shimotoriharuki/2021RoboTrace_Kicad/README.md

# 2021RoboTrace_Kicad

This repository contains circuit data for line-following robot ([UnderBird](https://www.youtube.com/watch?v=3UgktZoH9lk)).

Sourse code is [HERE](https://github.com/shimotoriharuki/2021RoboTracer).

Electronic components list is [HERE](https://lizard-building-630.notion.site/Electronic-components-list-d9b10301a8f747e9818a21101504a1fe).

# License: [GNU General Public License v3.0](https://github.com/shimotoriharuki/2021RoboTrace_Kicad/blob/master/COPYING)
