shimotoriharuki/2021RoboTrace_Kicad/MainBoard/DXF/MainBoard_v1.xlsx

Library | Part | Footprint | Value | Number | Reference
Connector | Micro_SD_Card_Det_Hirose_DM3AT | Connectors_Card:Hirose_DM3AT-SF-PEJM5 | Micro_SD_Card_Det_Hirose_DM3AT | 1 | J5
Connector_Generic | Conn_01x02 | Connectors_JST:JST_SH_BM02B-SRSS-TB_02x1.00mm_Straight | SH | 1 | J6
Connector_Generic | Conn_01x02 | Footprint:ILG_2pin | ILG | 1 | J1
Connector_Generic | Conn_01x02 | Footprint:PA_2pin | PA | 2 | J4, PA1
Connector_Generic | Conn_01x03 | Connectors_JST:JST_SH_BM03B-SRSS-TB_03x1.00mm_Straight | SH | 2 | J13, J11
Connector_Generic | Conn_01x04 | Connectors_JST:JST_SH_BM04B-SRSS-TB_04x1.00mm_Straight | SH | 3 | J2, J10, SH1
Connector_Generic | Conn_01x06 | Connectors_JST:JST_SH_BM06B-SRSS-TB_06x1.00mm_Straight | SH | 2 | J3, J9
Connector_Generic | Conn_01x18 | Footprint:Molex_FFC_18 | FFC | 1 | J12
Connector_Generic | Conn_02x05_Odd_Even | Pin_Headers:Pin_Header_Straight_2x05_Pitch1.27mm | ENC | 2 | J7, J8
Device | Buzzer | Footprint:SMT-0440-S-R | SMT-0440-S-R | 1 | BZ1
Device | CP_Small | Capacitors_SMD:CP_Elec_5x5.8 | 100u | 3 | C2, C27, C43
Device | C_Small | Capacitors_SMD:C_0603 | 0.1u | 15 | C1, C12, C13, C17, C19, C31, C34, C36, C30, C45, C47, C48, C50, C49, C46
Device | C_Small | Capacitors_SMD:C_0603 | 10u | 2 | C33, C44
Device | C_Small | Capacitors_SMD:C_0603 | 1u | 17 | C20, C25, C28, C29, C40, C14, C18, C23, C24, C35, C41, C42, C16, C21, C22, C37, C38
Device | C_Small | Capacitors_SMD:C_0603 | 2.2u | 2 | C39, C15
Device | C_Small | Capacitors_SMD:C_0603 | 3.3n | 1 | C6
Device | C_Small | Capacitors_SMD:C_0603 | 4.7u | 1 | C26
Device | C_Small | Capacitors_SMD:C_0805 | 22u | 4 | C7, C9, C10, C5
Device | C_Small | Capacitors_SMD:C_1210 | 47u | 5 | C3, C32, C4, C8, C11
Device | D_Schottky_Small_ALT | Diodes_SMD:D_SOD-123F | SS2040FL | 2 | D1, D7
Device | D_Zener_Small_ALT | Footprint:1SMB5930BT3G | 1SMB5920BT3G | 1 | D3
Device | D_Zener_Small_ALT | Footprint:1SMB5930BT3G | SZ1SMB5930BT3G | 1 | D2
Device | Ferrite_Bead_Small | Inductors_SMD:L_0603 | 330 | 1 | FB1
Device | Ferrite_Bead_Small | Inductors_SMD:L_0603 | 60 | 6 | FB2, FB3, FB4, FB5, FB6, FB7
Device | L | Footprint:IHLP1212BZER2R2M11 | IHLP1212BZER2R2M11 | 1 | L1
Device | LED_Small_ALT | LEDs:LED_0603 | OSTG1608C1A | 8 | D4, D5, D6, D8, D9, D10, D11, D12
Device | Q_NMOS_GSD | TO_SOT_Packages_SMD:SOT-23 | IRLML6344 | 1 | Q10
Device | R_Pack04 | Resistors_SMD:R_Array_Convex_4x1206 | 4.7k | 1 | RN1
Device | R_Small | Resistors_SMD:R_0603 | 1.2k | 1 | R53
Device | R_Small | Resistors_SMD:R_0603 | 100k | 1 | R2
Device | R_Small | Resistors_SMD:R_0603 | 10k | 14 | R1, R6, R29, R11, R12, R28, R30, R23, R24, R25, R26, R27, R57, R56
Device | R_Small | Resistors_SMD:R_0603 | 2.7k | 2 | R32, R33
Device | R_Small | Resistors_SMD:R_0603 | 22k | 7 | R15, R16, R17, R18, R19, R14, R20
Device | R_Small | Resistors_SMD:R_0603 | 2k | 1 | R4
Device | R_Small | Resistors_SMD:R_0603 | 33k | 2 | R13, R31
Device | R_Small | Resistors_SMD:R_0603 | 390 | 6 | R5, R48, R49, R50, R51, R52
Device | R_Small | Resistors_SMD:R_0603 | 4.7k | 2 | R8, R9
Device | R_Small | Resistors_SMD:R_0603 | 470 | 1 | R55
Device | R_Small | Resistors_SMD:R_0603 | 5k | 1 | R3
Device | R_Small | Resistors_SMD:R_0603 | 680 | 1 | R54
Device | R_Small | Resistors_SMD:R_0603 | R | 18 | R7, R10, R21, R22, R47, R46, R45, R44, R43, R42, R41, R40, R39, R38, R37, R36, R35, R34
Regulator_Switching | TPS62143 | Package_DFN_QFN:VQFN-16-1EP_3x3mm_P0.5mm_EP1.68x1.68mm_ThermalVias | TPS62143 | 1 | U3
Switch | SW_Coded_SH-7050 | Footprint:FR01SC16P | FR01SC16P-S | 1 | SW3
Switch | SW_Push | Footprint:SKRPACE010 | SKRPACE010 | 1 | SW1
Switch | SW_Push_SPDT | Footprint:SSSS213202 | SSSS213202 | 1 | SW2
Transistor_FET | 2N7002K | Package_TO_SOT_SMD:SOT-23 | 2N7002K | 1 | Q7
shimoharu_library | AON7400B | Housings_DFN_QFN:DFN-8-1EP_3x3mm_Pitch0.5mm | AON7400B | 8 | Q1, Q2, Q3, Q4, Q5, Q6, Q8, Q9
shimoharu_library | DRV8701E | Footprint:DRV8701ERGET | DRV8701E | 2 | U6, U10
shimoharu_library | ECS-2520S33 | Crystals:Crystal_SMD_2520-4pin_2.5x2.0mm | ECS-2520S33 | 1 | U4
shimoharu_library | ICM20648 | Footprint:ICM20648 | ICM20648 | 1 | U7
shimoharu_library | INA260 | Housings_SSOP:TSSOP-16_4.4x5mm_Pitch0.65mm | INA260 | 2 | U5, U9
shimoharu_library | LT1963EST-3.3 | TO_SOT_Packages_SMD:SOT-223-3_TabPin2 | LT1963EST-3.3 | 1 | U2
shimoharu_library | MMC5983MA | Footprint:MMC5983MA | MMC5983MA | 1 | U11
shimoharu_library | OSTB0603C1C-A | Footprint:OSTB0603C1C-A | OSTB0603C1C-A | 1 | LED1
shimoharu_library | SI7463DP | Footprint:SO-8_PowerPAK_Vishay_Single | SI7469DP-T1-GE3 | 1 | U1
shimoharu_library | SKRHAAE010 | Footprint:SKRHAAE010 | SKRHAAE010 | 1 | SW4
shimoharu_library | STM32F469VG | Housings_QFP:LQFP-100_14x14mm_Pitch0.5mm | STM32F469VG | 1 | U8
