shimotoriharuki/2021RoboTrace_Kicad/MainBoard/DXF/MainBoard.dxf

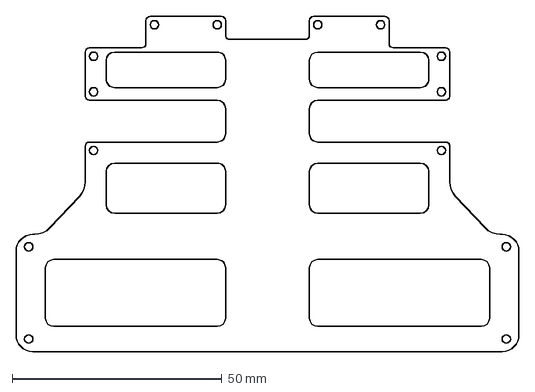
[picture p1: CAD file, 2021-05-12]
MainBoard/DXF/MainBoard.dxf
120.0 x 80.0 mm
