shimotoriharuki/2021RoboTrace_Kicad/MainBoard/MainBoard_v1.step

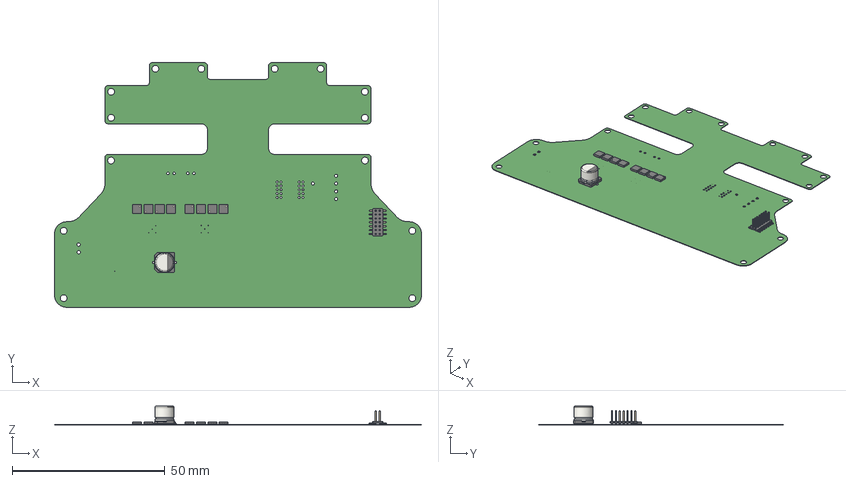
[picture p2: CAD file, 2021-06-06]
MainBoard/MainBoard_v1.step
120.0 x 80.0 x 6.15 mm
