shimotoriharuki/2021RoboTrace_Kicad/FollowingSensor/DXF/edge.dxf

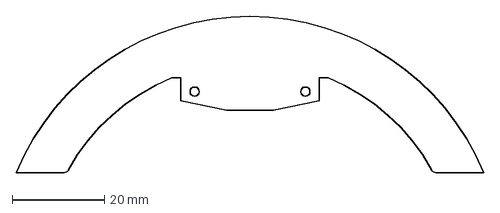
[picture p3: CAD file, 2021-05-12]
FollowingSensor/DXF/edge.dxf
101.6 x 33.9 mm
