shimotoriharuki/2021RoboTrace_Kicad/SideSensor/DXF/edge.dxf

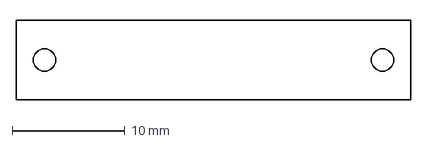
[picture p4: CAD file, 2021-05-12]
SideSensor/DXF/edge.dxf
35.0 x 7.10 mm
