shimotoriharuki/2021RoboTrace_Kicad/(list of files, cad)

Other CAD files:
MainBoard/circuitMainBoard_v1.ipt
