shimotoriharuki/2021RoboTrace_Kicad/FollowingSensor/PDF/FollowingSensor1.0.pdf

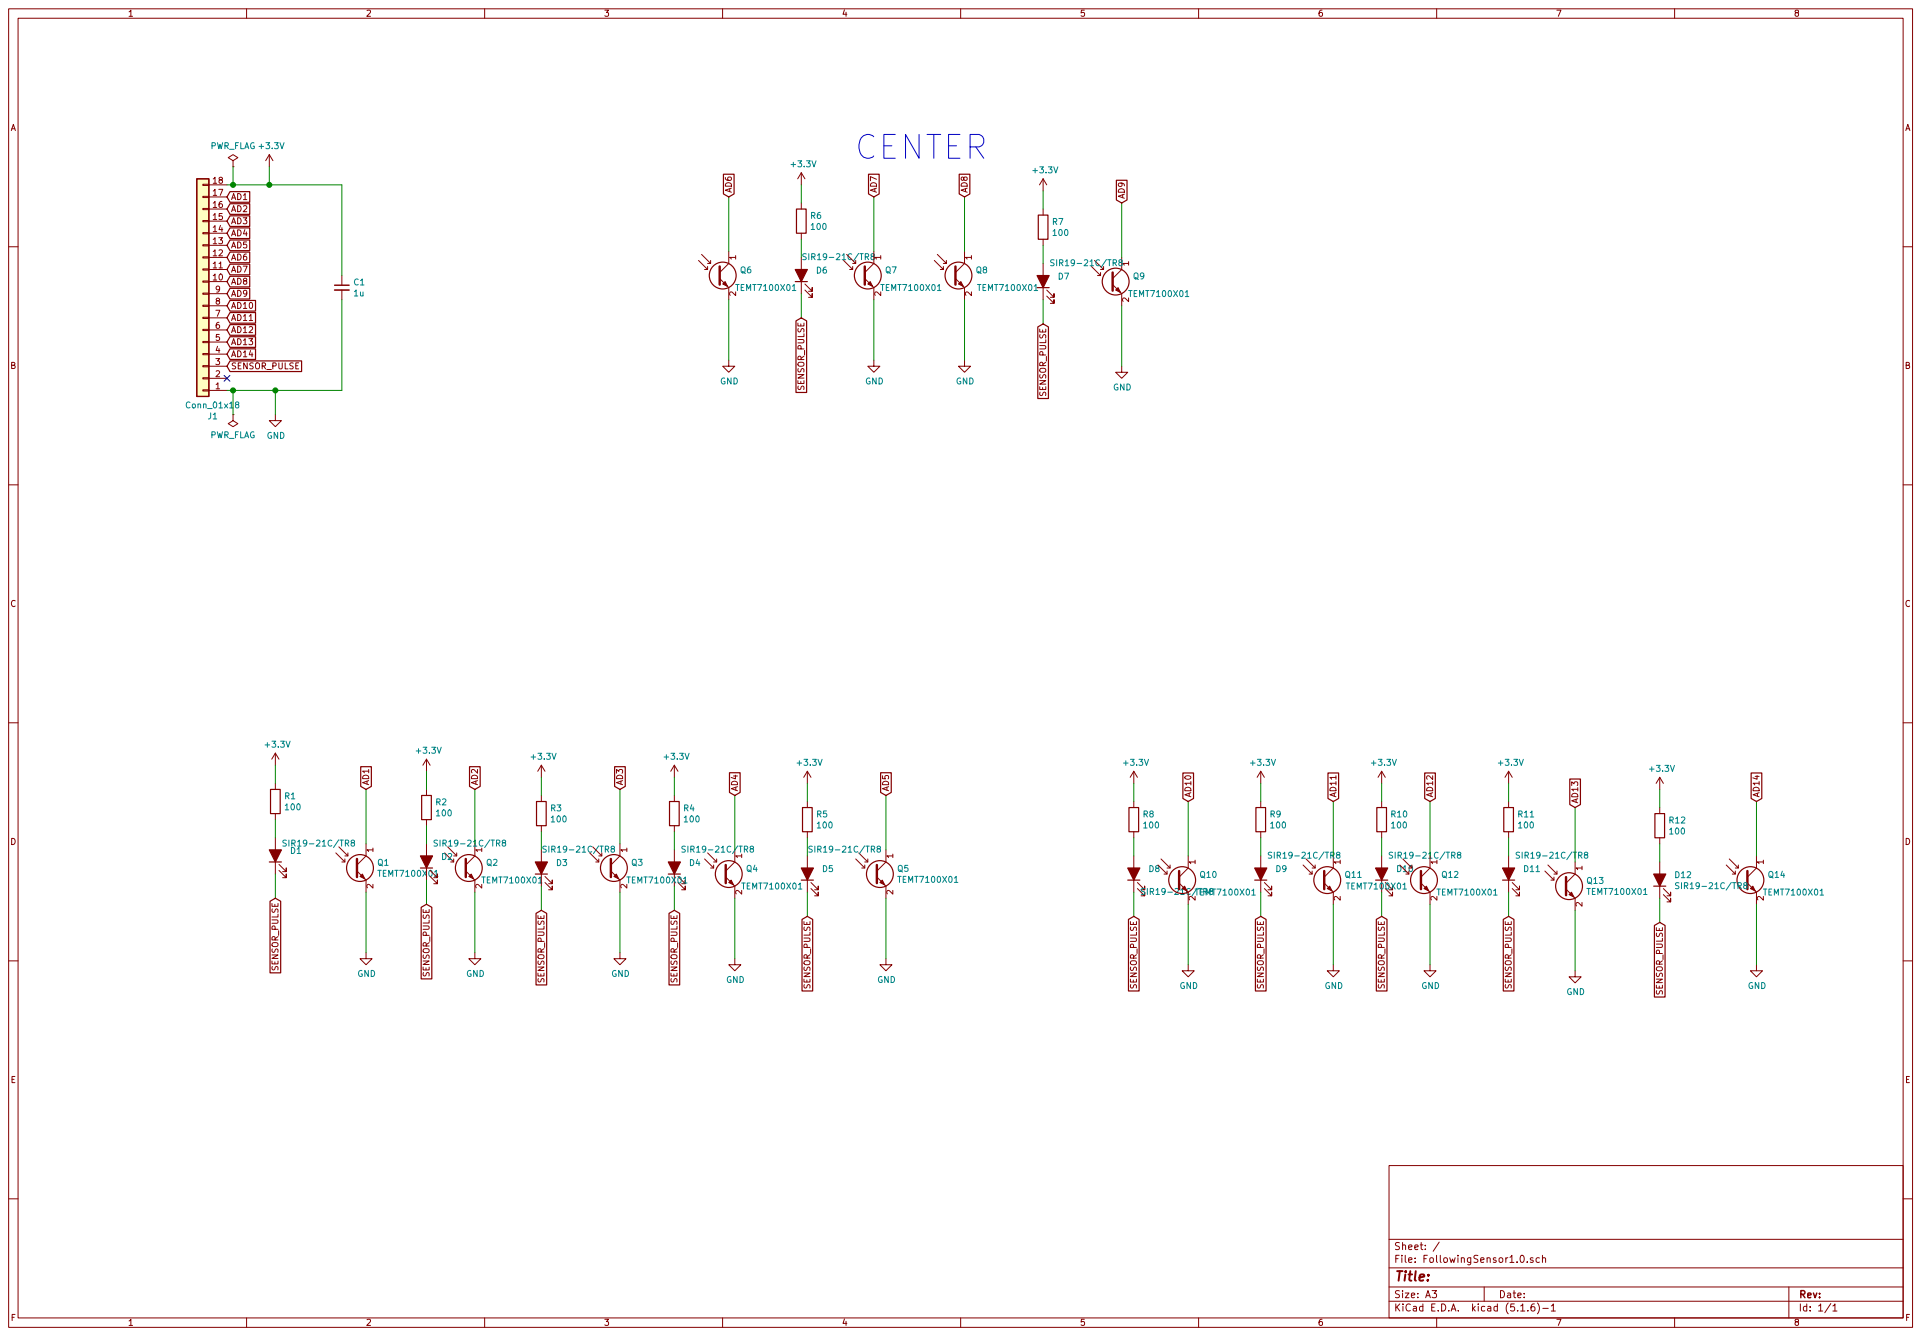
[picture p5: page 1]
