shimotoriharuki/2021RoboTrace_Kicad/MainBoard/PDF/MainBoard_v1.pdf

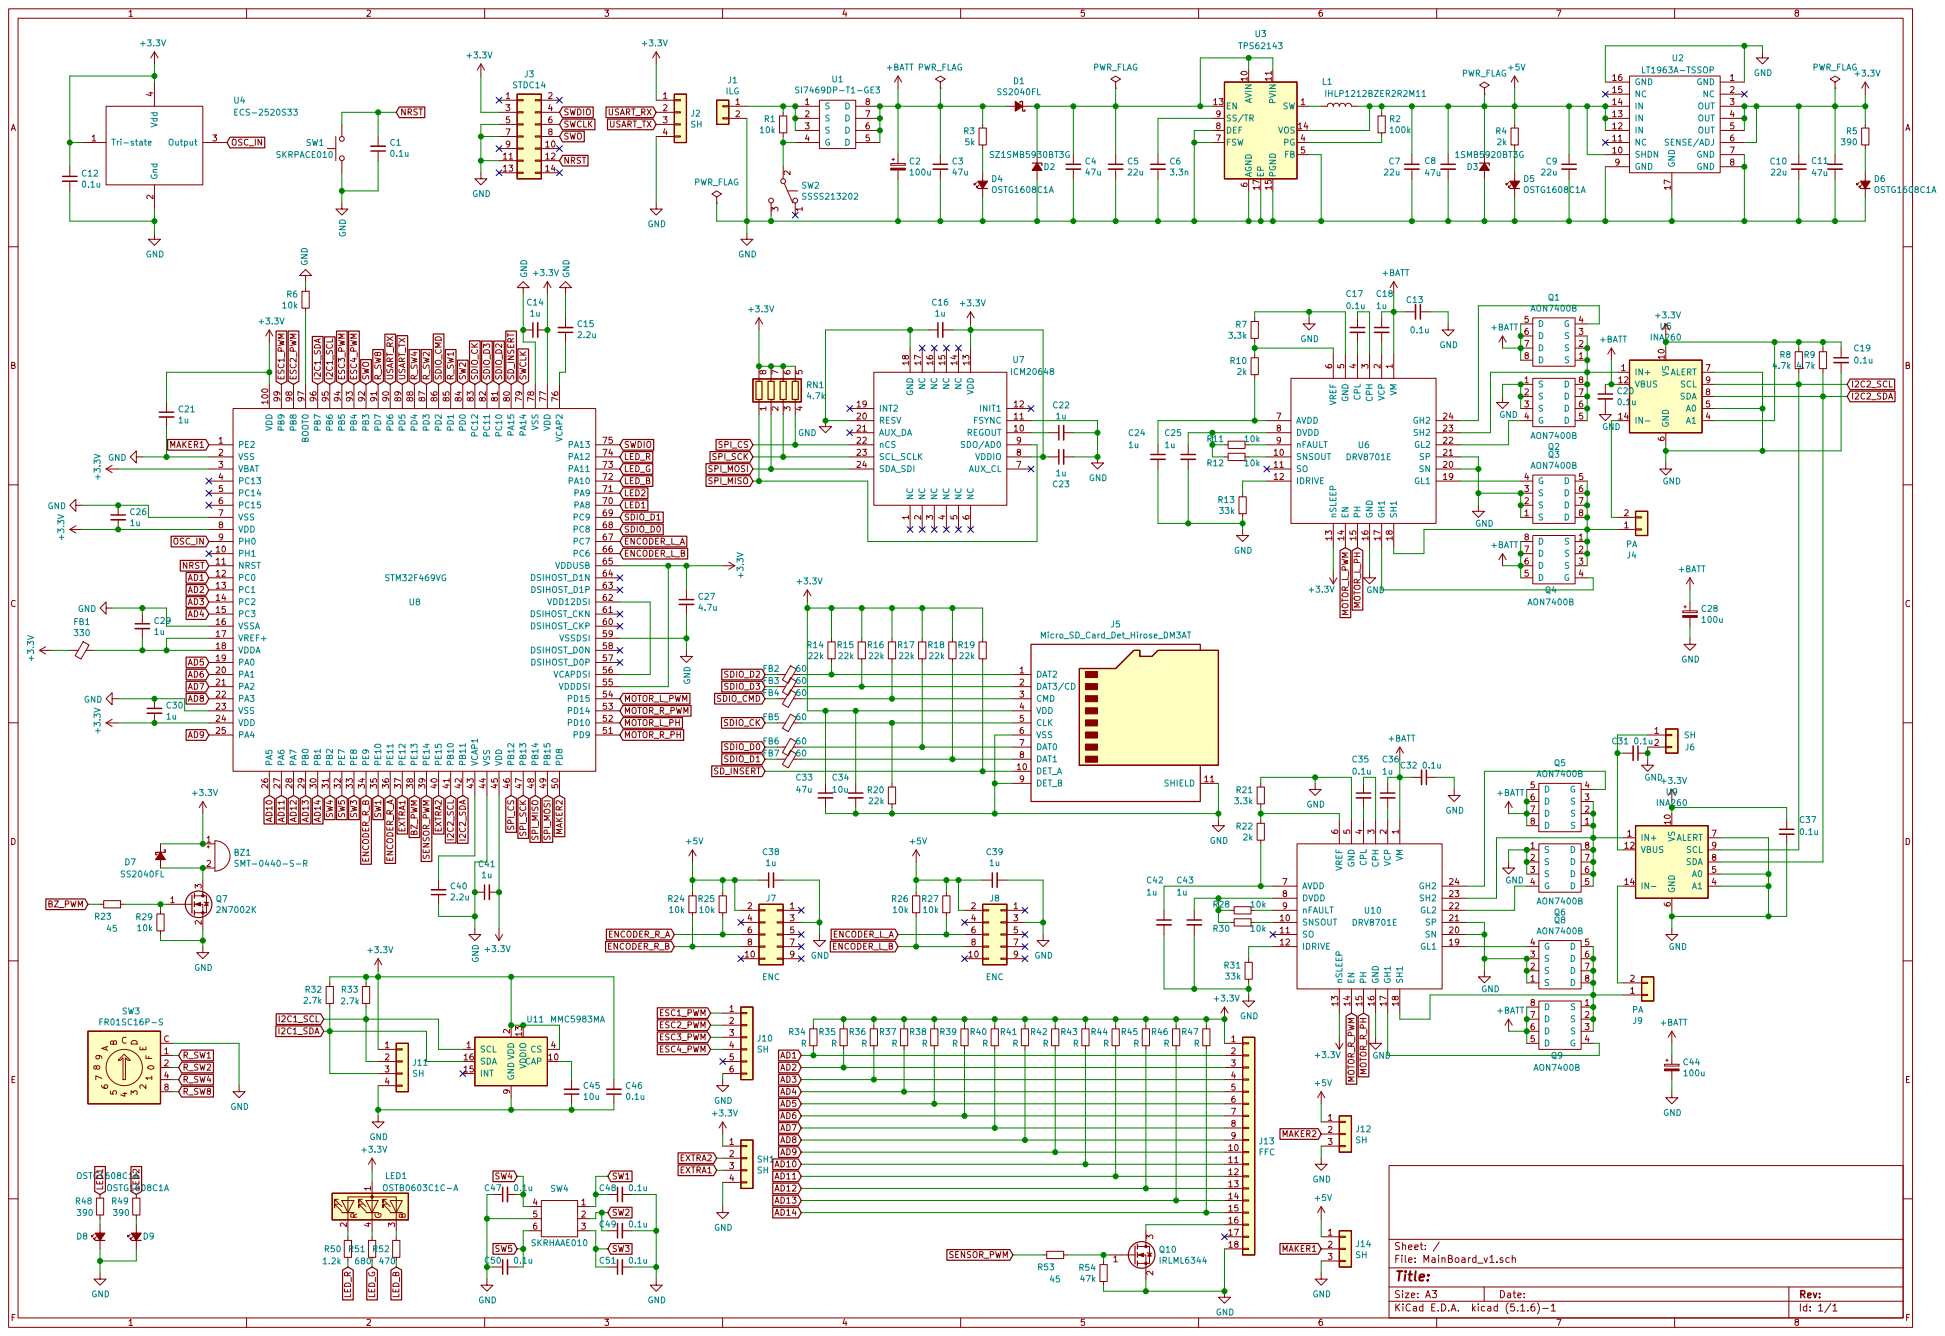
[picture p6: page 1]

6 FSW 7 DEF 8 SS/TR 9 U3 TPS62143
