shimotoriharuki/2021RoboTrace_Kicad/SideSensor/PDF/SideSensor.pdf

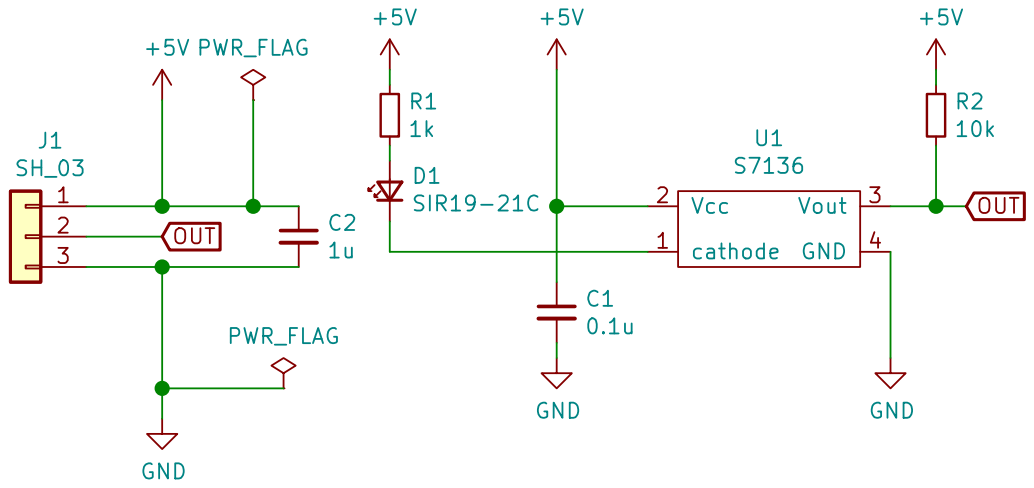
[picture p7: page 1]

Id: 1/1 Title: File: SideSensor.sch Sheet: /
