shimotoriharuki/2021RoboTrace_Kicad/MainBoard/MainBoard_v1.kicad_pcb

## KiCad design MainBoard/MainBoard_v1.kicad_pcb (2021-06-06)

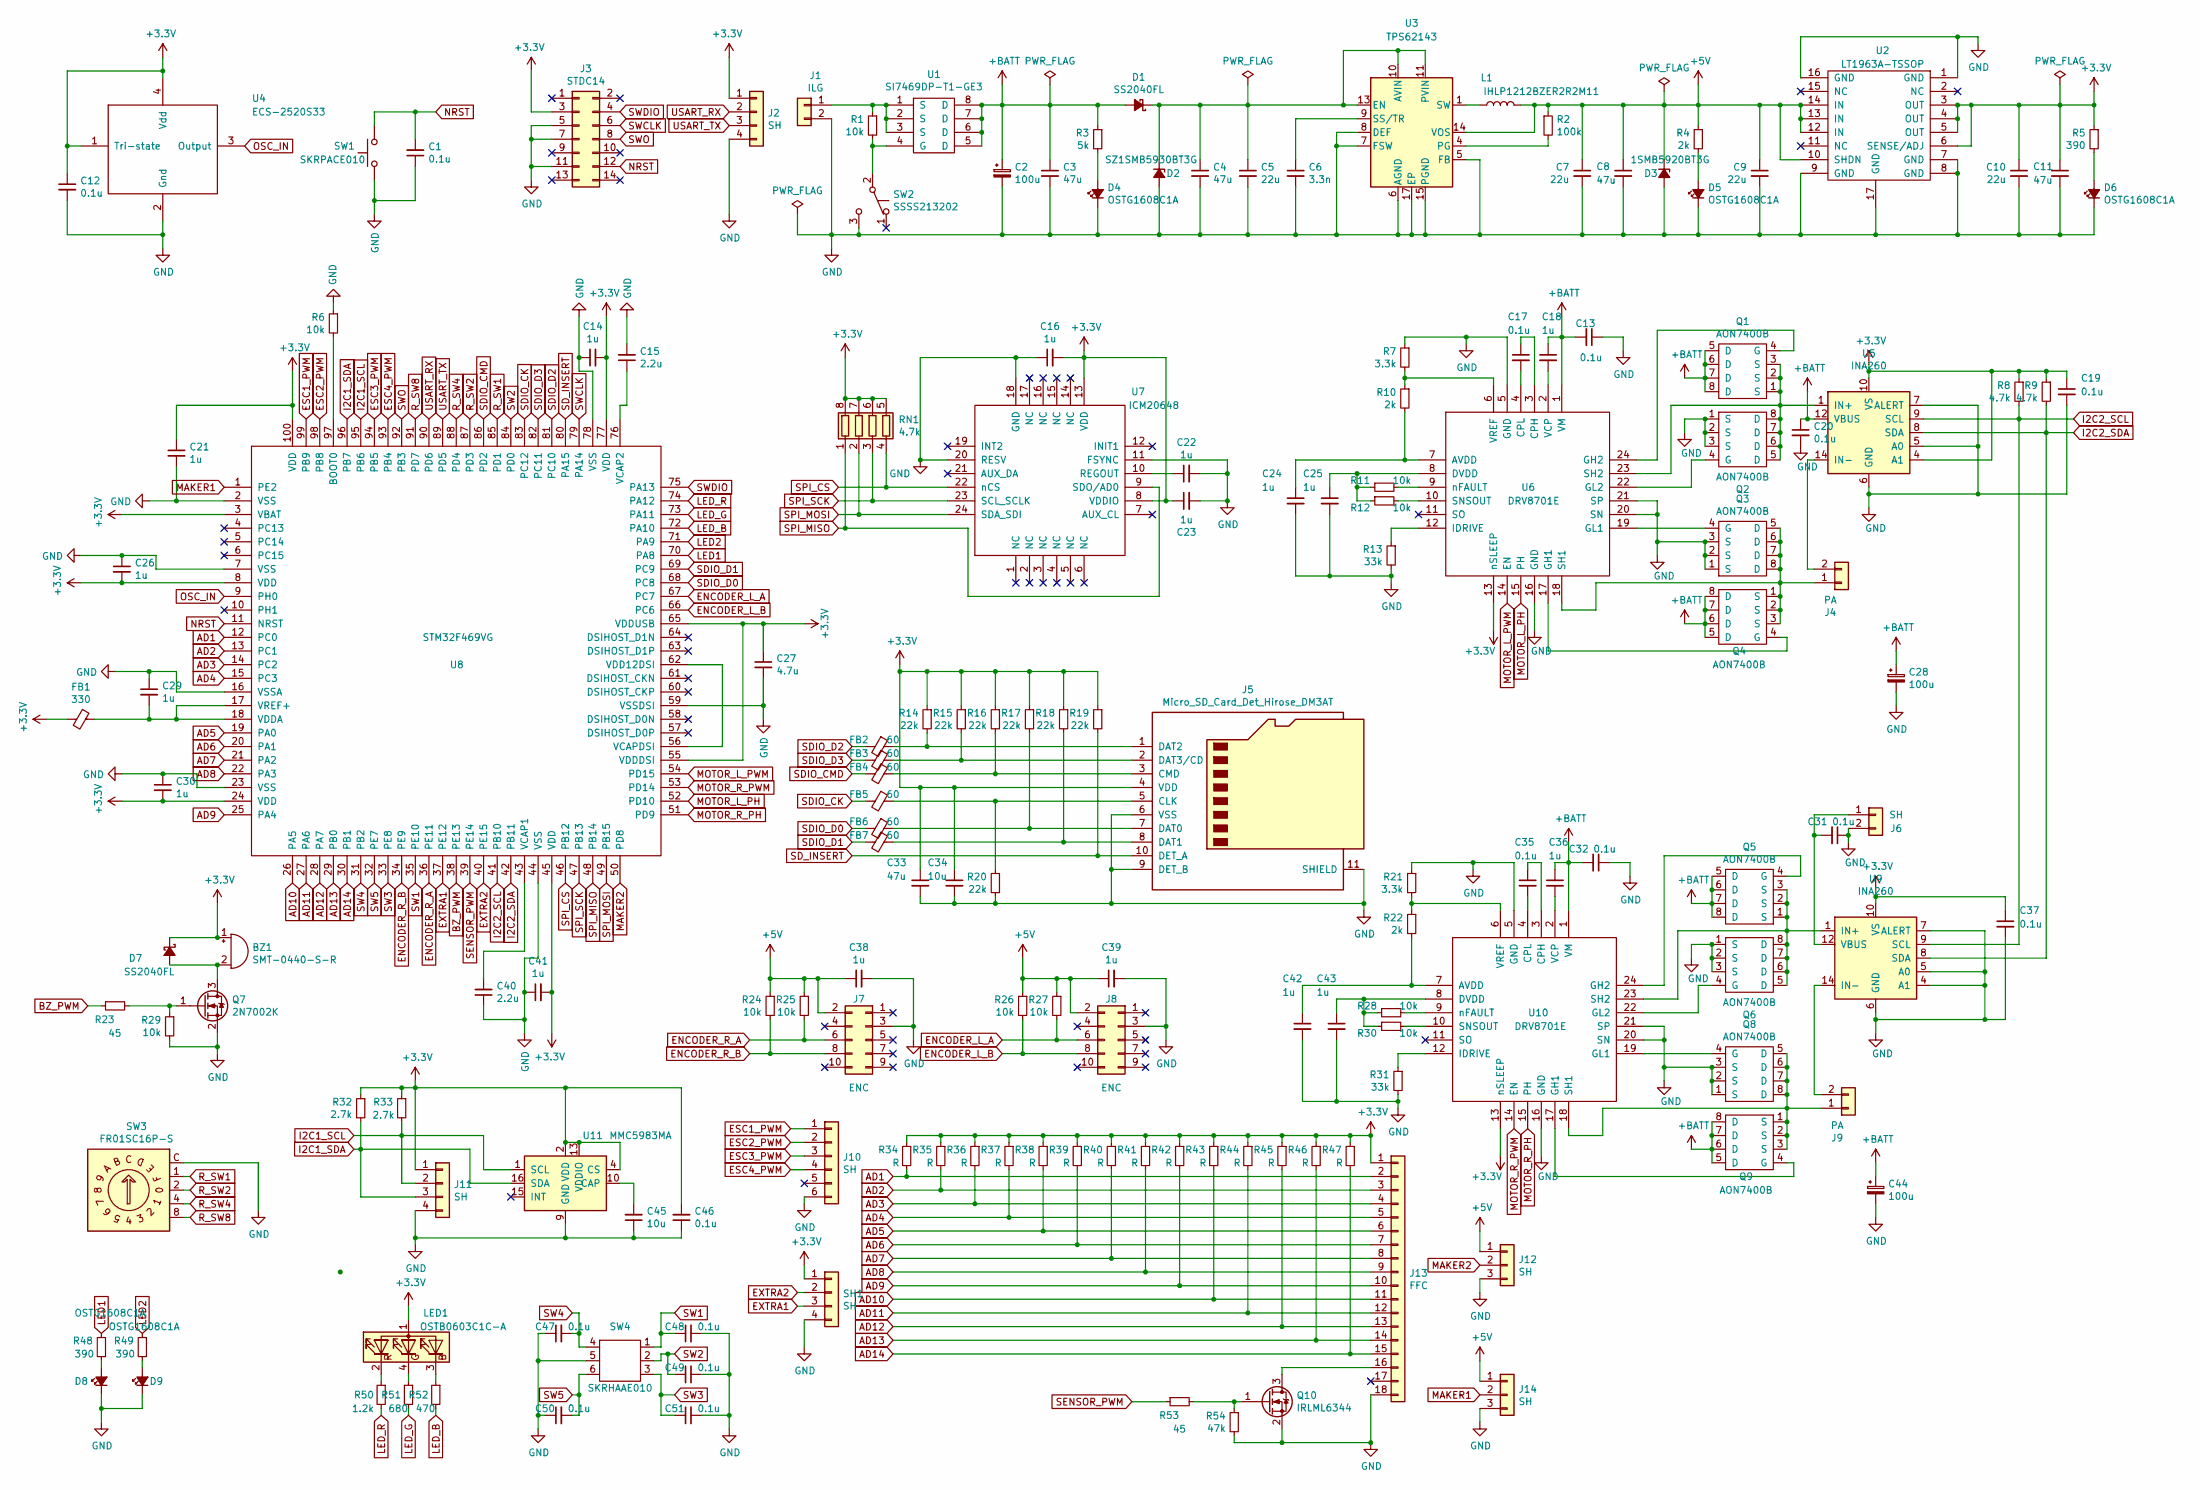
[picture p8: schematic MainBoard_v1.sch]

Parts:
BZ1: SMT-0440-S-R
C1, C12, C13, C17, C19, C20, C31, C32, C35, C37, C46, C47, C48, C49, C50, C51: 0.1u; C_0603
C2: 100u; CP_Elec_6.3x5.9
C3, C4, C8, C11, C33: 47u; C_1210
C5, C7, C9, C10: 22u; C_0805
C6: 3.3n; C_0603
C14, C16, C18, C21, C22, C23, C24, C25, C26, C29, C30, C36, C38, C39, C41, C42, C43: 1u; C_0603
C15, C40: 2.2u; C_0603
C27: 4.7u; C_0603
C28, C44: 100u; CP_Elec_5x5.8
C34, C45: 10u; C_0603
D1, D7: SS2040FL; D_SOD-123F
D2: SZ1SMB5930BT3G; 1SMB5930BT3G
D3: 1SMB5920BT3G; 1SMB5930BT3G
D4, D5, D6, D8, D9: OSTG1608C1A; LED_0603
FB1: 330; L_0603
FB2, FB3, FB4, FB5, FB6, FB7: 60; L_0603
J1: ILG; ILG_2pin
J2, J11: SH; JST_SH_BM04B-SRSS-TB_04x1.00mm_Straight
J3: STDC14; PinHeader_2x07_P1.27mm_Vertical_SMD
J4, J9: PA; PA_2pin
J5: Micro_SD_Card_Det_Hirose_DM3AT; Hirose_DM3AT-SF-PEJM5
J6: SH; JST_SH_BM02B-SRSS-TB_02x1.00mm_Straight
J7, J8: ENC; Pin_Header_Straight_2x05_Pitch1.27mm
J10: SH; JST_SH_BM06B-SRSS-TB_06x1.00mm_Straight
J12, J14: SH; JST_SH_BM03B-SRSS-TB_03x1.00mm_Straight
J13: FFC; Molex_FFC_18
L1: IHLP1212BZER2R2M11
LED1: OSTB0603C1C-A
Q1, Q2, Q3, Q4, Q5, Q6, Q8, Q9: AON7400B; DFN-8-1EP_3x3mm_P0.65mm_EP1.55x2.4mm
Q7: 2N7002K; SOT-23
Q10: IRLML6344; SOT-23
R1, R6, R11, R12, R24, R25, R26, R27, R28, R29, R30: 10k; R_0603
R2: 100k; R_0603
R3: 5k; R_0603
R4, R10, R22: 2k; R_0603
R5, R48, R49: 390; R_0603
R7, R21: 3.3k; R_0603
R8, R9: 4.7k; R_0603
R13, R31: 33k; R_0603
R14, R15, R16, R17, R18, R19, R20: 22k; R_0603
R23, R53: 45; R_0603
R32, R33: 2.7k; R_0603
R34, R35, R36, R37, R38, R39, R40, R41, R42, R43, R44, R45, R46, R47: R; R_0603
R50: 1.2k; R_0603
R51: 680; R_0603
R52: 470; R_0603
R54: 47k; R_0603
RN1: 4.7k; R_Array_Convex_4x1206
SH1: SH; JST_SH_BM04B-SRSS-TB_04x1.00mm_Straight
SW1: SKRPACE010
SW2: SSSS213202
SW3: FR01SC16P-S; FR01SC16P
SW4: SKRHAAE010
U1: SI7469DP-T1-GE3; SO-8_PowerPAK_Vishay_Single
U2: LT1963A-TSSOP; TSSOP-16-1EP_4.4x5mm_Pitch0.65mm
U3: TPS62143; TPS62143RGTR
U4: ECS-2520S33; Crystal_SMD_2520-4pin_2.5x2.0mm
U5, U9: INA260; TSSOP-16_4.4x5mm_Pitch0.65mm
U6, U10: DRV8701E; DRV8701ERGET
U7: ICM20648
U8: STM32F469VG; LQFP-100_14x14mm_Pitch0.5mm
U11: MMC5983MA

Connections:
+3V3: BZ1.1 (-), C10.1, C11.1, C12.1, C14.2, C16.2, C19.1, C21.1, C23.1, C26.2, C27.1, C30.2, C33.1, C34.1, C37.1, C41.2, C46.2, D7.1 (K), FB1.2, J2.1, J3.3, J5.4 (VDD), J11.1, J13.1, LED1.1, R5.1, R8.1, R9.1, R14.1, R15.1, R16.1, R17.1, R18.1, R19.1, R32.1, R33.1, R34.1, R35.1, R36.1, R37.1, R38.1, R39.1, R40.1, R41.1, R42.1, R43.1, R44.1, R45.1, R46.1, R47.1, RN1.5 (R4.2), RN1.6 (R3.2), RN1.7 (R2.2), RN1.8 (R1.2), SH1.1, U2.3 (OUT), U2.4 (OUT), U2.5 (OUT), U2.6 (SENSE/ADJ), U4.1 (Tri-state), U4.4 (Vdd), U5.4 (A1), U5.10 (VS), U6.13 (nSLEEP), U7.8 (VDDIO), U7.13 (VDD), U8.3 (VBAT), U8.8 (VDD), U8.24 (VDD), U8.45 (VDD), U8.55 (VDDDSI), U8.65 (VDDUSB), U8.77 (VDD), U8.100 (VDD), U9.10 (VS), U10.13 (nSLEEP), U11.2 (VDD), U11.4 (CS), U11.13 (VDDIO)
+5V: C7.1, C8.1, C9.1, C38.1, C39.1, D3.1 (K), J7.2, J8.2, J12.1, J14.1, L1.2, R2.1, R4.1, R24.1, R25.1, R26.1, R27.1, U2.10 (SHDN), U2.12 (IN), U2.13 (IN), U2.14 (IN), U3.14 (VOS)
+BATT: C2.1, C3.1, C13.2, C18.1, C20.1, C28.1, C32.2, C36.1, C44.1, D1.2 (A), Q1.5 (D), Q1.6 (D), Q1.7 (D), Q1.8 (D), Q4.5 (D), Q4.6 (D), Q4.7 (D), Q4.8 (D), Q5.5 (D), Q5.6 (D), Q5.7 (D), Q5.8 (D), Q9.5 (D), Q9.6 (D), Q9.7 (D), Q9.8 (D), R3.1, U1.5 (D), U1.6 (D), U1.7 (D), U1.8 (D), U5.12 (VBUS), U6.1 (VM), U10.1 (VM)
AD1: J13.2, R34.2, U8.12 (PC0)
AD2: J13.3, R35.2, U8.13 (PC1)
AD3: J13.4, R36.2, U8.14 (PC2)
AD4: J13.5, R37.2, U8.15 (PC3)
AD5: J13.6, R38.2, U8.19 (PA0)
AD6: J13.7, R39.2, U8.20 (PA1)
AD7: J13.8, R40.2, U8.21 (PA2)
AD8: J13.9, R41.2, U8.22 (PA3)
AD9: J13.10, R42.2, U8.25 (PA4)
AD10: J13.11, R43.2, U8.26 (PA5)
AD11: J13.12, R44.2, U8.27 (PA6)
AD12: J13.13, R45.2, U8.28 (PA7)
AD13: J13.14, R46.2, U8.29 (PB0)
AD14: J13.15, R47.2, U8.30 (PB1)
BZ_PWM: R23.1, U8.38 (PE13)
ENCODER_L_A: J8.6, R27.2, U8.67 (PC7)
ENCODER_L_B: J8.8, R26.2, U8.66 (PC6)
ENCODER_R_A: J7.6, R25.2, U8.36 (PE11)
ENCODER_R_B: J7.8, R24.2, U8.34 (PE9)
ESC1_PWM: J10.1, U8.99 (PB9)
ESC2_PWM: J10.2, U8.98 (PB8)
ESC3_PWM: J10.3, U8.94 (PB5)
ESC4_PWM: J10.4, U8.93 (PB4)
EXTRA1: SH1.3, U8.37 (PE12)
EXTRA2: SH1.2, U8.40 (PE15)
GND: C1.1, C2.2, C3.2, C4.2, C5.2, C6.2, C7.2, C8.2, C9.2, C10.2, C11.2, C12.2, C13.1, C14.1, C15.2, C16.1, C19.2, C20.2, C21.2, C22.2, C23.2, C24.2, C25.2, C26.1, C27.2, C28.2, C29.1, C30.1, C31.1, C32.1, C33.2, C34.2, C37.2, C38.2, C39.2, C40.1, C41.1, C42.2, C43.2, C44.2, C45.1, C46.1, C47.1, C48.2, C49.2, C50.1, C51.2, D2.2 (A), D3.2 (A), D4.1 (K), D5.1 (K), D6.1 (K), D8.1 (K), D9.1 (K), J1.2, J2.4, J3.5, J3.7, J3.11, J5.6 (VSS), J5.9 (DET_B), J5.11 (SHIELD), J6.2, J7.3, J8.3, J10.6, J11.4, J12.3, J13.18, J14.3, Q2.1 (S), Q2.2 (S), Q2.3 (S), Q3.1 (S), Q3.2 (S), Q3.3 (S), Q6.1 (S), Q6.2 (S), Q6.3 (S), Q7.2 (S), Q8.1 (S), Q8.2 (S), Q8.3 (S), Q10.2 (S), R6.1, R7.1, R13.2, R20.2, R21.1, R29.2, R31.2, R54.2, SH1.4, SW1.2, SW2.3 (C), SW3.C, SW4.5, U2.1 (GND), U2.7 (GND), U2.8 (GND), U2.9 (GND), U2.16 (GND), U2.17 (GND), U3.5 (FB), U3.6 (AGND), U3.7 (FSW), U3.8 (DEF), U3.15 (PGND), U3.16 (PGND), U3.17 (EP), U4.2 (Gnd), U5.5 (A0), U5.6 (GND), U5.7 (ALERT), U5.11 (GND), U6.5 (GND), U6.16 (GND), U6.20 (SN), U6.21 (SP), U7.11 (FSYNC), U7.18 (GND), U7.20 (RESV), U8.2 (VSS), U8.7 (VSS), U8.16 (VSSA), U8.23 (VSS), U8.44 (VSS), U8.59 (VSSDSI), U8.78 (VSS), U9.4 (A1), U9.5 (A0), U9.6 (GND), U9.7 (ALERT), U9.11 (GND), U10.5 (GND), U10.16 (GND), U10.20 (SN), U10.21 (SP), U11.9 (GND), U11.11 (GND)
I2C1_SCL: J11.2, R33.2, U8.95 (PB6), U11.1 (SCL)
I2C1_SDA: J11.3, R32.2, U8.96 (PB7), U11.16 (SDA)
I2C2_SCL: R8.2, U5.9 (SCL), U8.41 (PB10), U9.9 (SCL)
I2C2_SDA: R9.2, U5.8 (SDA), U8.42 (PB11), U9.8 (SDA)
LED1: R48.1, U8.70 (PA8)
LED2: R49.1, U8.71 (PA9)
LED_B: R52.2, U8.72 (PA10)
LED_G: R51.2, U8.73 (PA11)
LED_R: R50.2, U8.74 (PA12)
MAKER1: J14.2, U8.1 (PE2)
MAKER2: J12.2, U8.50 (PD8)
MOTOR_L_PH: U6.15 (PH), U8.52 (PD10)
MOTOR_L_PWM: U6.14 (EN), U8.54 (PD15)
MOTOR_R_PH: U8.51 (PD9), U10.15 (PH)
MOTOR_R_PWM: U8.53 (PD14), U10.14 (EN)
NRST: C1.2, J3.12, SW1.1, U8.11 (NRST)
unnamed: BZ1.2 (+), D7.2 (A), Q7.3 (D)
unnamed: C4.1, C5.1, D1.1 (K), D2.1 (K), U3.10 (AVIN), U3.11 (PVIN), U3.12 (PVIN), U3.13 (EN)
unnamed: C6.1, U3.9 (SS/TR)
unnamed: C15.1, U8.76 (VCAP2)
unnamed: C17.1, U6.3 (CPH)
unnamed: C17.2, U6.4 (CPL)
unnamed: C18.2, U6.2 (VCP)
unnamed: C22.1, U7.10 (REGOUT)
unnamed: C24.1, R10.2, U6.7 (AVDD)
unnamed: C25.1, R11.1, R12.1, U6.8 (DVDD)
unnamed: C29.2, FB1.1, U8.17 (VREF+), U8.18 (VDDA)
unnamed: C31.2, J6.1, U9.12 (VBUS)
unnamed: C35.1, U10.3 (CPH)
unnamed: C35.2, U10.4 (CPL)
unnamed: C36.2, U10.2 (VCP)
unnamed: C40.2, U8.43 (VCAP1)
unnamed: C42.1, R22.2, U10.7 (AVDD)
unnamed: C43.1, R28.1, R30.1, U10.8 (DVDD)
unnamed: C45.2, U11.10 (CAP)
unnamed: D4.2 (A), R3.2
unnamed: D5.2 (A), R4.2
unnamed: D6.2 (A), R5.2
unnamed: D8.2 (A), R48.2
unnamed: D9.2 (A), R49.2
unnamed: FB2.1, J5.1 (DAT2), R14.2
unnamed: FB3.1, J5.2 (DAT3/CD), R15.2
unnamed: FB4.1, J5.3 (CMD), R16.2
unnamed: FB5.1, J5.5 (CLK), R20.1
unnamed: FB6.1, J5.7 (DAT0), R17.2
unnamed: FB7.1, J5.8 (DAT1), R18.2
unnamed: J1.1, R1.1, U1.1 (S), U1.2 (S), U1.3 (S)
unnamed: J4.1, Q3.5 (D), Q3.6 (D), Q3.7 (D), Q3.8 (D), Q4.1 (S), Q4.2 (S), Q4.3 (S), U6.18 (SH1)
unnamed: J4.2, U5.14 (IN-), U5.15 (IN-), U5.16 (IN-)
unnamed: J9.1, Q8.5 (D), Q8.6 (D), Q8.7 (D), Q8.8 (D), Q9.1 (S), Q9.2 (S), Q9.3 (S), U10.18 (SH1)
unnamed: J9.2, U9.14 (IN-), U9.15 (IN-), U9.16 (IN-)
unnamed: J13.16, Q10.3 (D)
unnamed: L1.1, U3.1 (SW), U3.2 (SW), U3.3 (SW)
unnamed: LED1.2, R50.1
unnamed: LED1.3, R52.1
unnamed: LED1.4, R51.1
unnamed: Q1.1 (S), Q1.2 (S), Q1.3 (S), Q2.5 (D), Q2.6 (D), Q2.7 (D), Q2.8 (D), U5.1 (IN+), U5.2 (IN+), U5.3 (IN+), U6.23 (SH2)
unnamed: Q1.4 (G), U6.24 (GH2)
unnamed: Q2.4 (G), U6.22 (GL2)
unnamed: Q3.4 (G), U6.19 (GL1)
unnamed: Q4.4 (G), U6.17 (GH1)
unnamed: Q5.1 (S), Q5.2 (S), Q5.3 (S), Q6.5 (D), Q6.6 (D), Q6.7 (D), Q6.8 (D), U9.1 (IN+), U9.2 (IN+), U9.3 (IN+), U10.23 (SH2)
unnamed: Q5.4 (G), U10.24 (GH2)
unnamed: Q6.4 (G), U10.22 (GL2)
unnamed: Q7.1 (G), R23.2, R29.1
unnamed: Q8.4 (G), U10.19 (GL1)
unnamed: Q9.4 (G), U10.17 (GH1)
unnamed: Q10.1 (G), R53.2, R54.1
unnamed: R1.2, SW2.2 (B), U1.4 (G)
unnamed: R2.2, U3.4 (PG)
unnamed: R6.2, U8.97 (BOOT0)
unnamed: R7.2, R10.1, U6.6 (VREF)
unnamed: R11.2, U6.9 (nFAULT)
unnamed: R12.2, U6.10 (SNSOUT)
unnamed: R13.1, U6.12 (IDRIVE)
unnamed: R21.2, R22.1, U10.6 (VREF)
unnamed: R28.2, U10.9 (nFAULT)
unnamed: R30.2, U10.10 (SNSOUT)
unnamed: R31.1, U10.12 (IDRIVE)
unnamed: U8.56 (VCAPDSI), U8.62 (VDD12DSI)
OSC_IN: U4.3 (Output), U8.9 (PH0)
R_SW1: SW3.1, U8.85 (PD1)
R_SW2: SW3.2, U8.87 (PD3)
R_SW4: SW3.4, U8.88 (PD4)
R_SW8: SW3.8, U8.91 (PD7)
SDIO_CK: FB5.2, U8.83 (PC12)
SDIO_CMD: FB4.2, U8.86 (PD2)
SDIO_D0: FB6.2, U8.68 (PC8)
SDIO_D1: FB7.2, U8.69 (PC9)
SDIO_D2: FB2.2, U8.81 (PC10)
SDIO_D3: FB3.2, U8.82 (PC11)
SD_INSERT: J5.10 (DET_A), R19.2, U8.80 (PA15)
SENSOR_PWM: R53.1, U8.39 (PE14)
SPI_CS: RN1.4 (R4.1), U7.22 (nCS), U8.46 (PB12)
SPI_MISO: RN1.1 (R1.1), U7.9 (SDO/AD0), U8.48 (PB14)
SPI_MOSI: RN1.2 (R2.1), U7.24 (SDA_SDI), U8.49 (PB15)
SPI_SCK: RN1.3 (R3.1), U7.23 (SCL_SCLK), U8.47 (PB13)
SW1: C48.1, SW4.1, U8.35 (PE10)
SW2: C49.1, SW4.2, U8.84 (PD0)
SW3: C51.1, SW4.3, U8.33 (PE8)
SW4: C47.2, SW4.4, U8.31 (PB2)
SW5: C50.2, SW4.6, U8.32 (PE7)
SWCLK: J3.6, U8.79 (PA14)
SWDIO: J3.4, U8.75 (PA13)
SWO: J3.8, U8.92 (PB3)
USART_RX: J2.2, U8.90 (PD6)
USART_TX: J2.3, U8.89 (PD5)

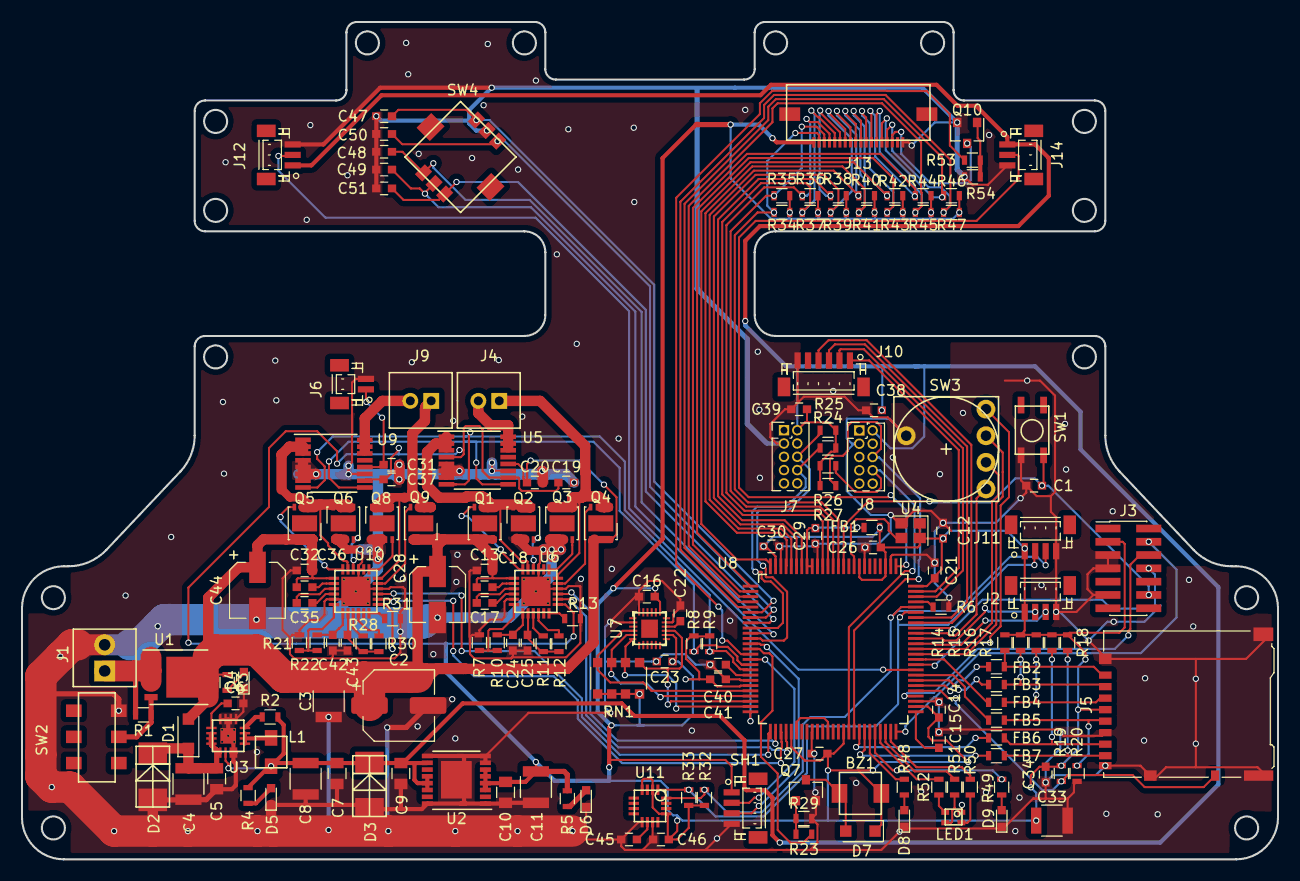
[picture p9: board MainBoard_v1.kicad_pcb from above]

Board: 2 copper layers, 120.0 x 80.0 mm, 165 parts (0 on the bottom side), 136 nets.
