shimotoriharuki/2021RoboTrace_Kicad/SideSensor/SideSensor.kicad_pcb

## KiCad design SideSensor/SideSensor.kicad_pcb (2021-06-06)

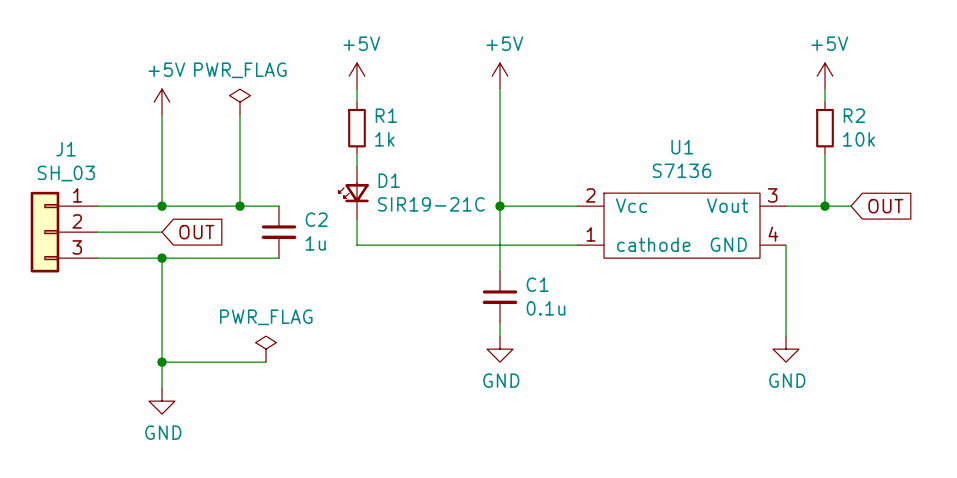
[picture p10: schematic SideSensor.sch]

Parts:
C1: 0.1u; C_0603_1608Metric
C2: 1u; C_0603_1608Metric
D1: SIR19-21C
J1: SH_03; JST_SH_BM03B-SRSS-TB_1x03-1MP_P1.00mm_Vertical
R1: 1k; R_0603_1608Metric
R2: 10k; R_0603_1608Metric
U1: S7136

Connections:
+5V: C1.1, C2.1, J1.1, R1.1, R2.1, U1.2 (Vcc)
GND: C1.2, C2.2, J1.3, U1.4 (GND)
unnamed: D1.1 (K), U1.1 (cathode)
unnamed: D1.2 (A), R1.2
OUT: J1.2, R2.2, U1.3 (Vout)

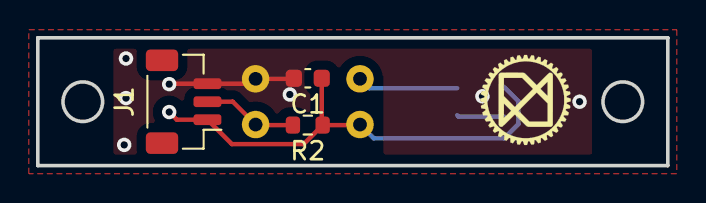
[picture p11: board SideSensor.kicad_pcb from above]

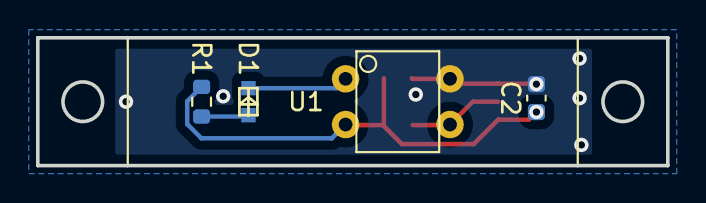
[picture p12: board SideSensor.kicad_pcb from below]

Board: 2 copper layers, 35.0 x 7.1 mm, 7 parts (4 on the bottom side), 5 nets.
