shimotoriharuki/2021RoboTrace_Kicad/FollowingSensor/FollowingSensor1.0.kicad_pcb

## KiCad design FollowingSensor/FollowingSensor1.0.kicad_pcb (2021-05-12)

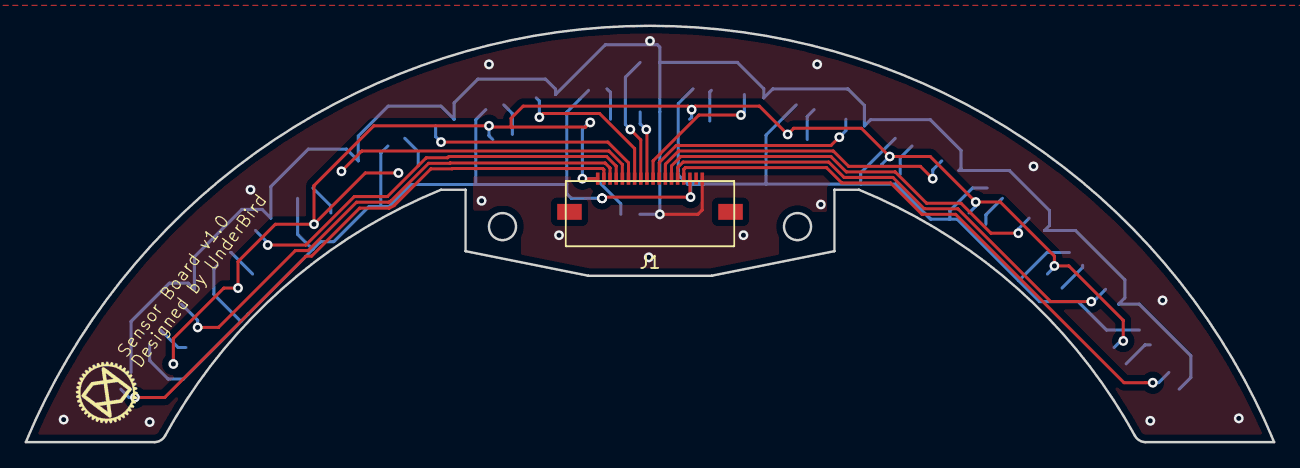
[picture p13: board FollowingSensor1.0.kicad_pcb from above]

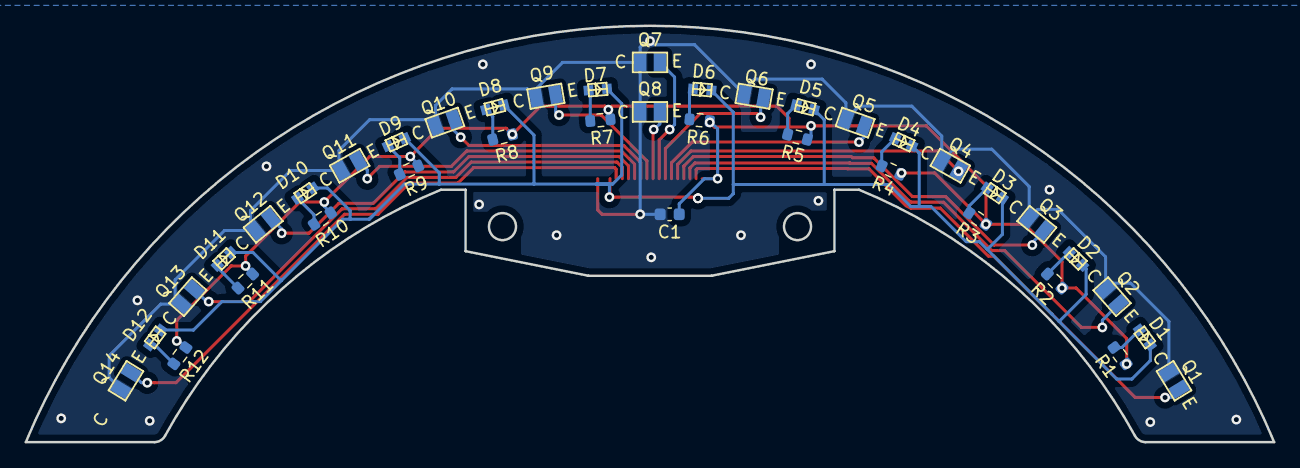
[picture p14: board FollowingSensor1.0.kicad_pcb from below]

Board: 2 copper layers, 101.6 x 33.9 mm, 40 parts (39 on the bottom side), 29 nets.

Parts:
C1: 1u; C_0603_1608Metric
D1, D2, D3, D4, D5, D6, D7, D8, D9, D10, D11, D12: SIR19-21C/TR8; SIR19-21C
J1: Conn_01x18; Molex_FFC_18
Q1, Q2, Q3, Q4, Q5, Q6, Q7, Q8, Q9, Q10, Q11, Q12, Q13, Q14: TEMT7100X01
R1, R2, R3, R4, R5, R6, R7, R8, R9, R10, R11, R12: R; R_0603_1608Metric

Connections:
+3V3: C1.1, J1.18, R1.1, R2.1, R3.1, R4.1, R5.1, R6.1, R7.1, R8.1, R9.1, R10.1, R11.1, R12.1
AD1: J1.17, Q1.1
AD2: J1.16, Q2.1
AD3: J1.15, Q3.1
AD4: J1.14, Q4.1
AD5: J1.13, Q5.1
AD6: J1.12, Q6.1
AD7: J1.11, Q7.1
AD8: J1.10, Q8.1
AD9: J1.9, Q9.1
AD10: J1.8, Q10.1
AD11: J1.7, Q11.1
AD12: J1.6, Q12.1
AD13: J1.5, Q13.1
AD14: J1.4, Q14.1
GND: C1.2, J1.1, Q1.2, Q2.2, Q3.2, Q4.2, Q5.2, Q6.2, Q7.2, Q8.2, Q9.2, Q10.2, Q11.2, Q12.2, Q13.2, Q14.2
unnamed: D1.2, R1.2
unnamed: D2.2, R2.2
unnamed: D3.2, R3.2
unnamed: D4.2, R4.2
unnamed: D5.2, R5.2
unnamed: D6.2, R6.2
unnamed: D7.2, R7.2
unnamed: D8.2, R8.2
unnamed: D9.2, R9.2
unnamed: D10.2, R10.2
unnamed: D11.2, R11.2
unnamed: D12.2, R12.2
SENSOR_PULSE: D1.1, D2.1, D3.1, D4.1, D5.1, D6.1, D7.1, D8.1, D9.1, D10.1, D11.1, D12.1, J1.3
