shimotoriharuki/2021RoboTrace_Kicad/(commit log)

2020-07-06 もう少しで完成
    [MainBoard_v1.kicad_pcb, MainBoard_v1.sch]
2021-05-08 update edge
    [MainBoard.dxf, MainBoard_v1.kicad_pcb]
2021-05-08 fixed up_right
    [MainBoard_v1.kicad_pcb]
2021-05-09 fixed right bottom
    [MainBoard_v1.kicad_pcb, MainBoard_v1.sch]
2021-05-10 fixed up right
    [MainBoard_v1.kicad_pcb]
2021-05-10 wiring completed
    [MainBoard_v1.kicad_pcb, MainBoard_v1.sch]
2021-05-10 sensor on the way
    [FollowingSensor1.0.kicad_pcb, edge.dxf]
2021-05-11 placement phototransister
    [FollowingSensor1.0.kicad_pcb, FollowingSensor1.0.sch]
2021-05-11 following sensor designed
    [FollowingSensor1.0.kicad_pcb, FollowingSensor1.0.sch]
2021-05-11 fixed main_board
    [MainBoard_v1.kicad_pcb]
2021-05-11 fixed sensor_board
    [FollowingSensor1.0.kicad_pcb]
2021-05-11 add side sensor
    [SideSensor.kicad_pcb, SideSensor.sch, edge.dxf]
2021-05-11 add logo
    [FollowingSensor1.0.kicad_pcb, SideSensor.kicad_pcb]
2021-05-12 remove antena and move referencse by main board
    [FollowingSensor1.0.kicad_pcb, MainBoard_v1.kicad_pcb, MainBoard_v1.sch, SideSensor.kicad_pcb]
2021-05-12 moved reference
    [FollowingSensor1.0.kicad_pcb]
2021-05-12 moved silks
    [MainBoard_v1.kicad_pcb]
2021-05-12 before confirmation
    [FollowingSensor1.0.kicad_pcb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]
2021-05-12 change capaciter size
    [MainBoard_v1.kicad_pcb, MainBoard_v1.sch]
2021-05-12 export gerber
    [FollowingSensor1.0.kicad_pcb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]
2021-05-13 change FET footprint
    [MainBoard_v1.kicad_pcb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]
2021-06-06 センサの抵抗値などを変更
    [FollowingSensor1.0.sch, MainBoard_v1.kicad_pcb, MainBoard_v1.sch, MainBoard_v1.step, SideSensor.kicad_pcb, SideSensor.sch, circuitMainBoard_v1.ipt]
2021-06-08 再プッシュ
2022-09-22 ファイル構成変更と回路図のpdf追加
    [FollowingSensor1.0.kicad_pcb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]
